steewbsd/quincy/doc/MaterialList.ods

Sheet: IC
Component | Type | Value | Size | Provider
EFM32GG11B120F2048GQ64 | MCU | N/A | TQFP | DigiKey
FL4000157Z | HF Crystal | 48MHz 15pF | 3.2mm*2.5mm | DigiKey
G8327A058 | LF Crystal | 32.768kHz 12.5 pF | 3.2mm*1.5mm | DigiKey
BMI088 | IMU | N/A | 16LGA | DigiKey
FAN7888MX | 3-P Gate Driver | N/A | 28-SOIC | DigiKey
TLP2366 | Optoisolator | 40ns | SO-6 | DigiKey
1984620 | Term. Block | 3 hole, 12A, 5mm | N/A | DigiKey
BQ7694202PFBR | Battery Protector | 3S – 10S | TQFP-48 | DigiKey
AMT49406GLPTR | BLDC Controller | FOC | 24-TSSOP-EP | DigiKey
IRF540NPBF | High Side FET | N-CH Si 100V 33A | TO-220AB | DigiKey
IRF540NPBF | Low Side FET | N-CH Si 100V 33A | TO-220AB | DigiKey
BM61M22BFJ-C | Isolated Gate Driver | 1ch 2500Vrms 60ns | SOP-JW8 | DigiKey
DRV8300UDPWR | Gate Driver | Three Phase BLDC | 20-TSSOP | DigiKey
IMC101TT038XUMA1 | BLDC Controller | Three Phase BLDC | TSSOP-38 | DigiKey
MICRF219AAYQS-TR | Receiver RF ASK/OOK | 433MHz @ 20Kbps | 16QSOP | DigiKey
ABLS-13.52127MHZ-10-J-4Q-T | XTAL RF | 13.52MHz | HC-47/US | DigiKey
AS179-92LF | RF Switch | Max 2GHz, 0.4 dB IL, P1Db = 34 dBm, 50 Ohm | SC-70-6 | DigiKey
MICRF113YM6-TR | Transmitter RF ASK | 433Mhz @ 115 Kbps | SOT23-6 | DigiKey
RF2-04A-T-00-50-G | SMA Receptacle | 50 Ohm, Female |  | DigiKey
AO3400A | N-MOS FET | Vgs = 1.05 V | SOT-23-3L | DigiKey
AO3401A | P-MOS FET | Vgs = -0.9 V | SOT-23-3L | DigiKey
BAT46W-7-F | Rev. Protection Diode | Vr = 100 V, Schottky | SOD-123 | DigiKey
ERT-J1VR103J | Thermistor NTC | Ra = 10K, 1% | Pearl | DigiKey
ITV5432L1230WR | Fuse Triggerable | 30 A, 12 V | 5.4mm x 3.2mm x 1.8mm | DigiKey
FCX495TA | BJT REG | 100V,1A,2.3W,100 MHz | TO-252-3 DPAK | DigiKey
TPS562202S | Voltage Reg.
36-1122-ND | Battery Holder | 21700 |  | DigiKey

Sheet: Capacitors
Component | Type | Value | Size | Provider
CC0603BRNPO9BN1R2 | Cap. C0G | 1.2 pF | 0603 | DigiKey
CC0603BRNPO9BN1R5 | Cap. C0G | 1.5 pF | 0603 | DigiKey
CL10C4R7BB8NNNC | Cap. C0G | 4.7 pF | 0603 | DigiKey
CL21C100CBANNNC | Cap. C0G | 10 pF | 0805 | DigiKey
CL10C120JB8NNNC | Cap. C0G | 12 pF | 0603 | DigiKey
CL21C101JBANNNC | Cap. C0G | 100 pF | 0805 | DigiKey
CL21C221JBANNNC | Cap. C0G | 220 pF | 0805 | DigiKey
CL21B222KDCNFNC | Cap. X7R | 2.2 nF | 0805 | DigiKey
CL21B472KDCNNNC | Cap. X7R | 4.7 nF | 0805 | DigiKey
CL21B103KBANNNC | Cap. X5R | 10 nF | 0805 | DigiKey
CL21B104KBCNNNC | Cap. X7R | 0.1 uF | 0805 | DigiKey
CL21B224KBFNFNE | Cap. X7R | 0.22 uF | 0805 | DigiKey
CL21B474KBFNNNG | Cap. X7R | 0.47 uF | 0805 | DigiKey
CL21B105KAFNNNE | Cap. X7R | 1 uF | 0805 | DigiKey
CL21B225KPFNNNE | Cap. X7R | 2.2 uF | 0805 | DigiKey
CL21A106KOQNNNE | Cap. X5R | 10 uF | 0805 | DigiKey
CL21X226MOYNNWE | Cap. X6S | 22 uF | 0805 | DigiKey

Sheet: Resistors
Component | Type | Value | Size | Provider
ERJ-6GEY0R00V | RES 5% ⅛ W | 0 Ohm | 0805 | DigiKey
CRE2512-FZ-R005E-2 | RES 1% 2W | 5 mOhm | 2512 | DigiKey
ERJ-6RQF1R0V | RES 1% ⅛ W | 1 Ohm | 0805 | DigiKey
ERJ-6GEYJ100V | RES 5% ⅛ W | 10 Ohm | 0805 | DigiKey
ERJ-6GEYJ200V | RES 5% ⅛ W | 20 Ohm | 0805 | DigiKey
ERJ-6GEYJ101V | RES 5% ⅛ W | 100 Ohm | 0805 | DigiKey
ERJ-6ENF2001V | RES 1% ⅛ W | 2 kOhm | 0805 | DigiKey
ERJ-6ENF3901V | RES 5% ⅛ W | 3.9 kOhm | 0805 | DigiKey
ERJ-6GEYJ472V | RES 5% ⅛ W | 4.7 kOhm | 0805 | DigiKey
ERJ-6GEYJ103V | RES 5% ⅛ W | 10 kOhm | 0805 | DigiKey
ERJ-6ENF3092V | RES 1% ⅛ W | 30.9 kOhm | 0805 | DigiKey
ERJ-6GEYJ513V | RES 5% ⅛ W | 50 kOhm | 0805 | DigiKey
ERJ-6GEYJ104V | RES 5% ⅛ W | 100 kOhm | 0805 | DigiKey
ERJ-6GEYJ304V | RES 5% ⅛ W | 300 kOhm | 0805 | DigiKey
ERJ-6GEYJ106V | RES 5% ⅛ W | 10 Mohm | 0805 | DigiKey

Sheet: Inductors
Component | Type | Value | Size | Provider
AWCS0016100833NJ00 | RF Choke | 33 nH | 0603 | DigiKey
BWCS0012070739NJ00 | RF Choke | 39 nH | 0402 | DigiKey
LQW18AS68NG00D | RF Choke | 68 nH | 0603 | DigiKey
BWLS00100606R47K00 | RF Choke | 470 nH | 0402 | DigiKey
VLS5045EX-3R3N | Inductor 4.2A | 3.3 uH | N.S. | DigiKey
