steewbsd/quincy/doc/output/edgecuts.dxf

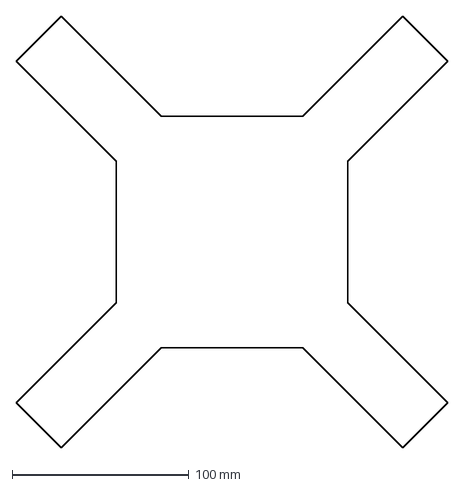
[picture p1: CAD file, 2024-11-16]
doc/output/edgecuts.dxf
244.0 x 244.0 mm
