steewbsd/quincy/(list of files, cad)

Other CAD files:
doc/EdgeCuts.FCStd
