steewbsd/quincy/doc/output/qfmu.pdf

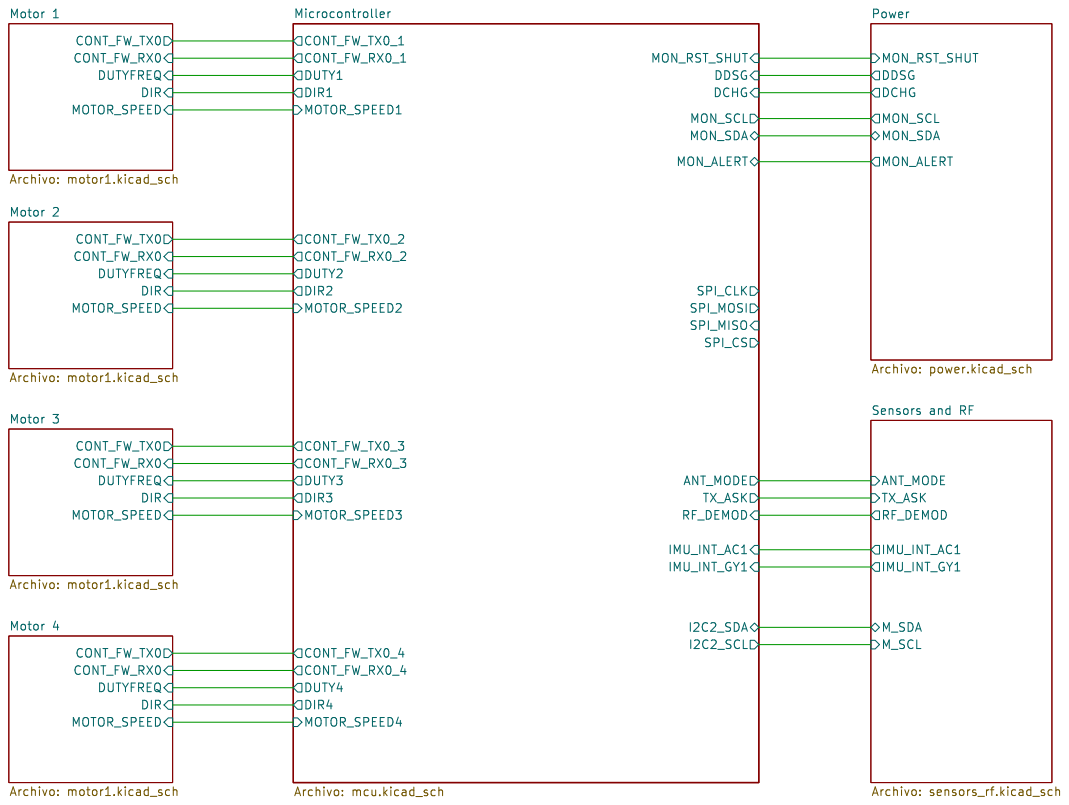
[picture p2: page 1]

Power Archivo: power.kicad_sch
I2C2_SCL MON_RST_SHUT DDSG
DCHG MON_SCL MON_SDA MON_ALERT RF_DEMOD
Sensors and RF Archivo: sensors_rf.kicad_sch

Id: 1/8 Title: Quincy FMU

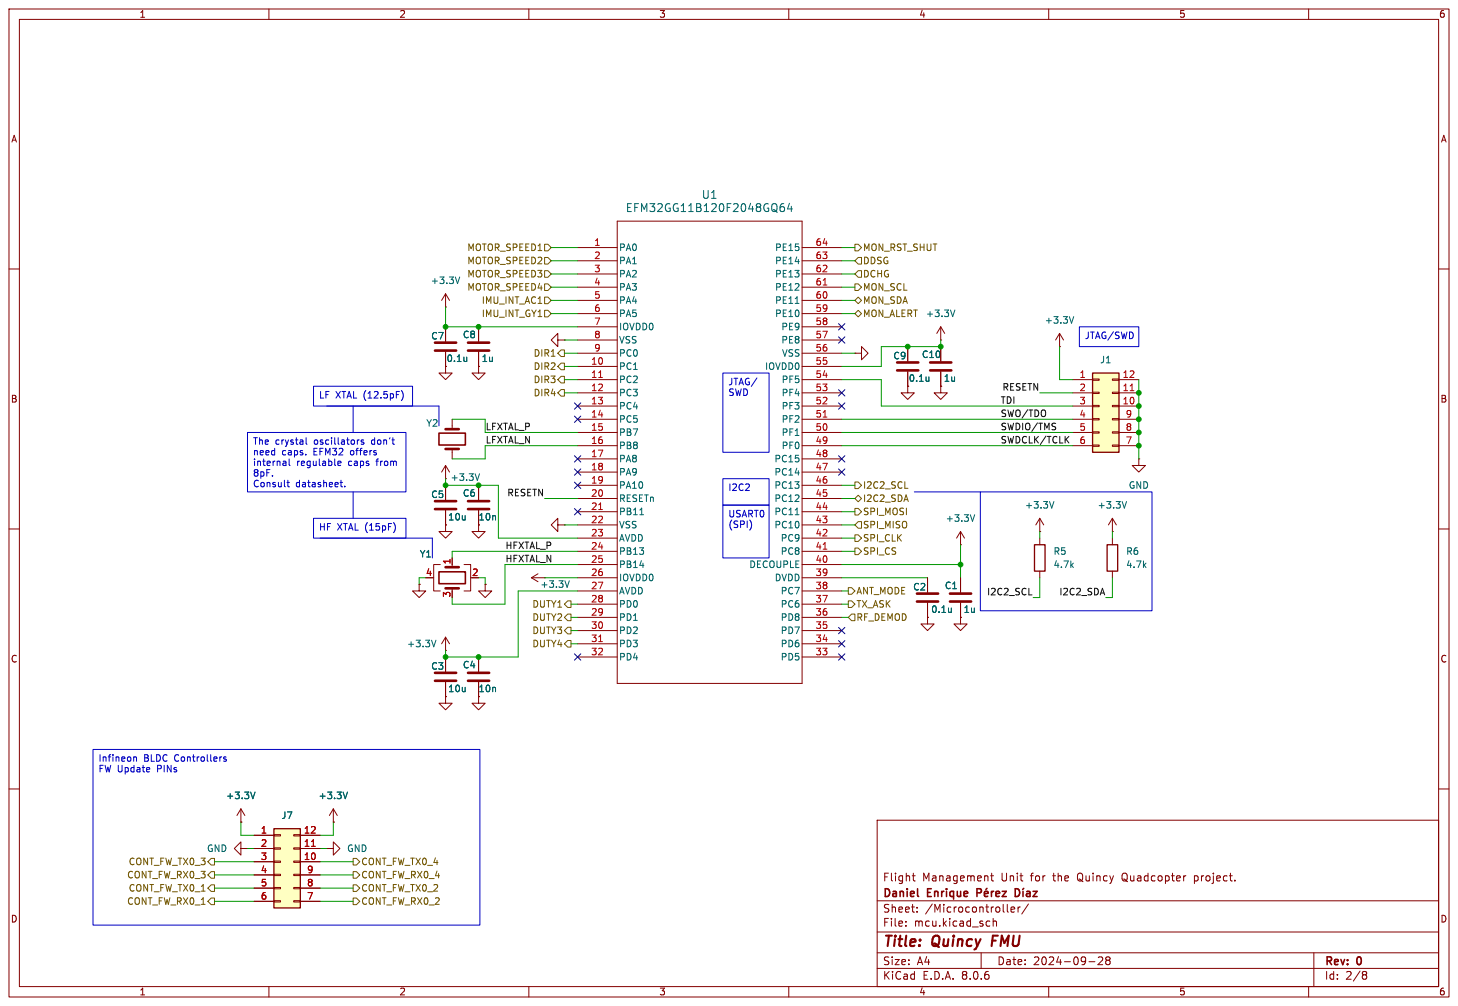
[picture p3: page 2]

Id: 2/8 Title: Quincy FMU

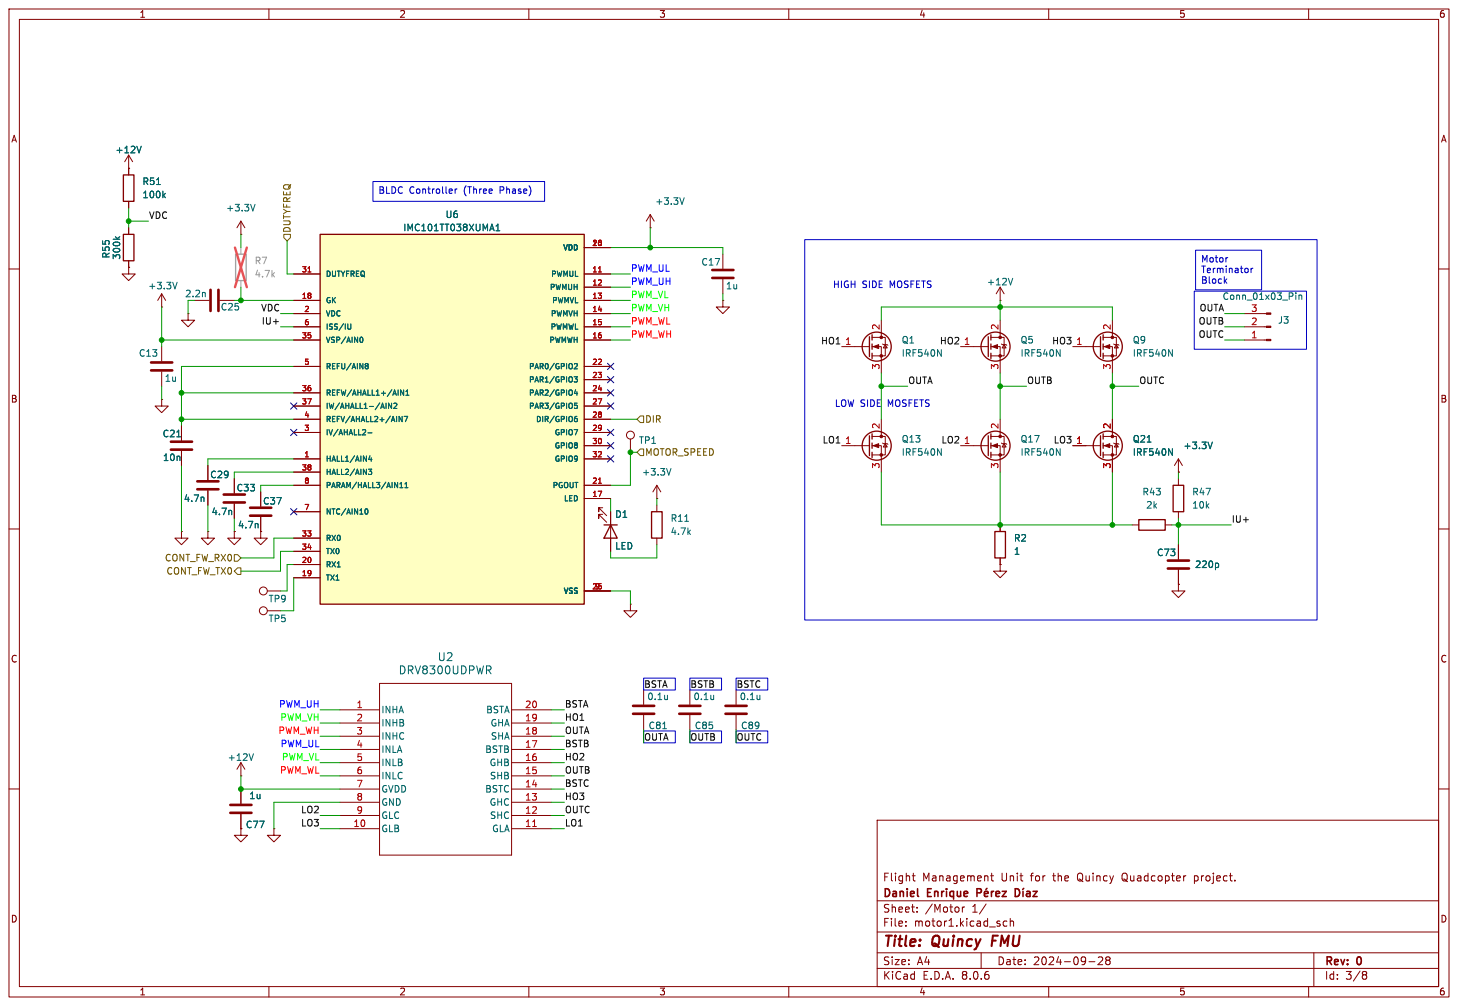
[picture p4: page 3]

LOW SIDE MOSFETS HIGH SIDE MOSFETS

Id: 3/8 Title: Quincy FMU

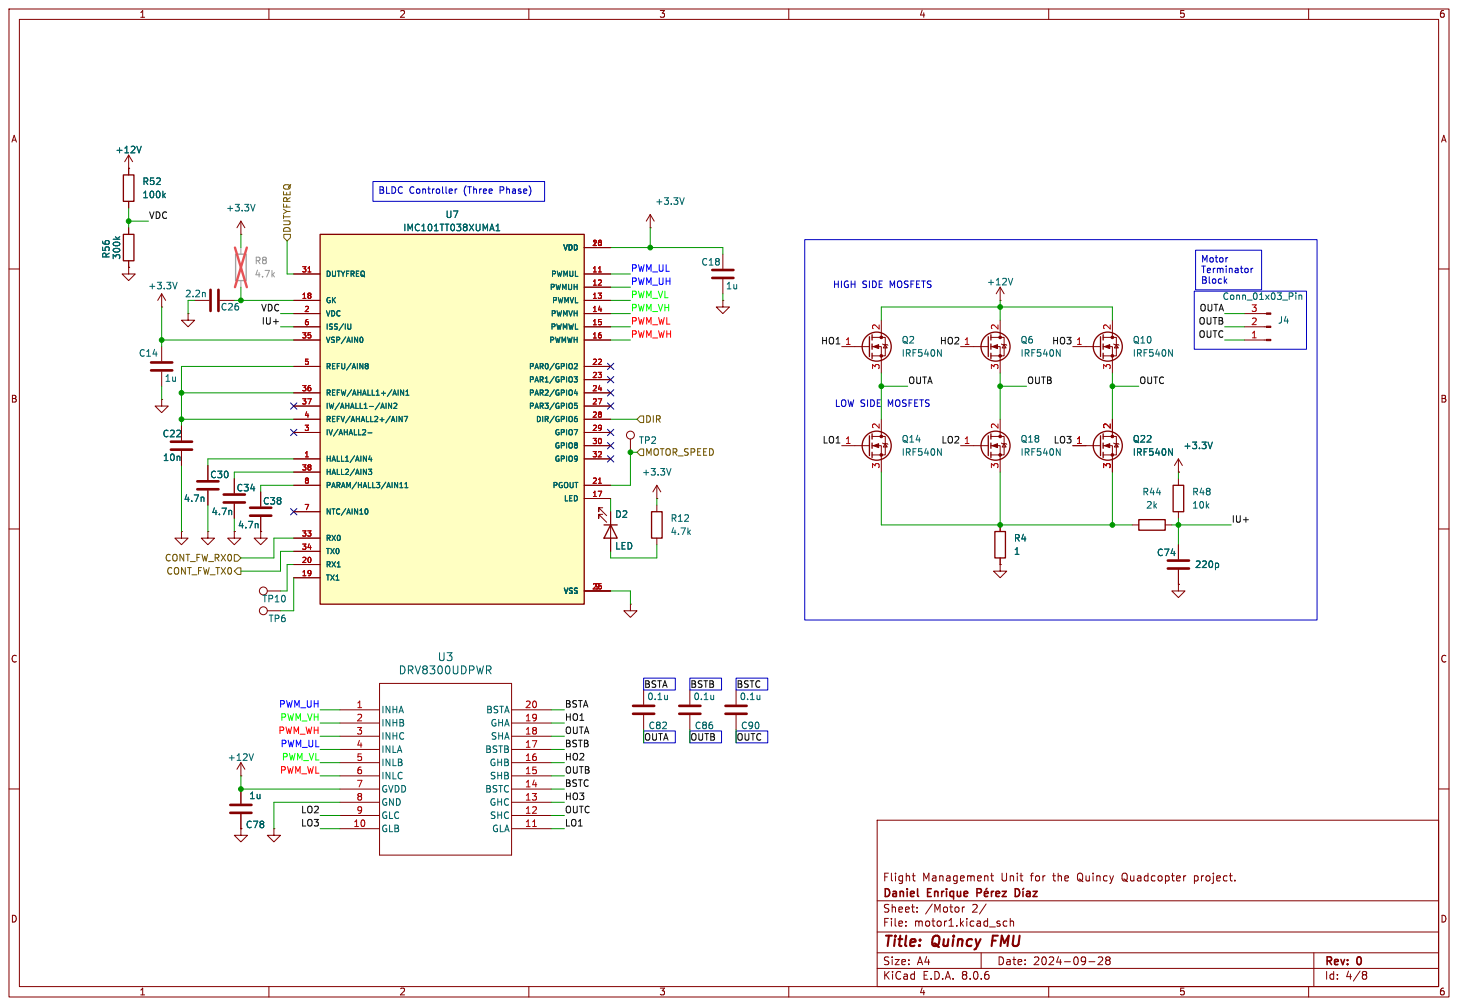
[picture p5: page 4]

Id: 4/8 Title: Quincy FMU

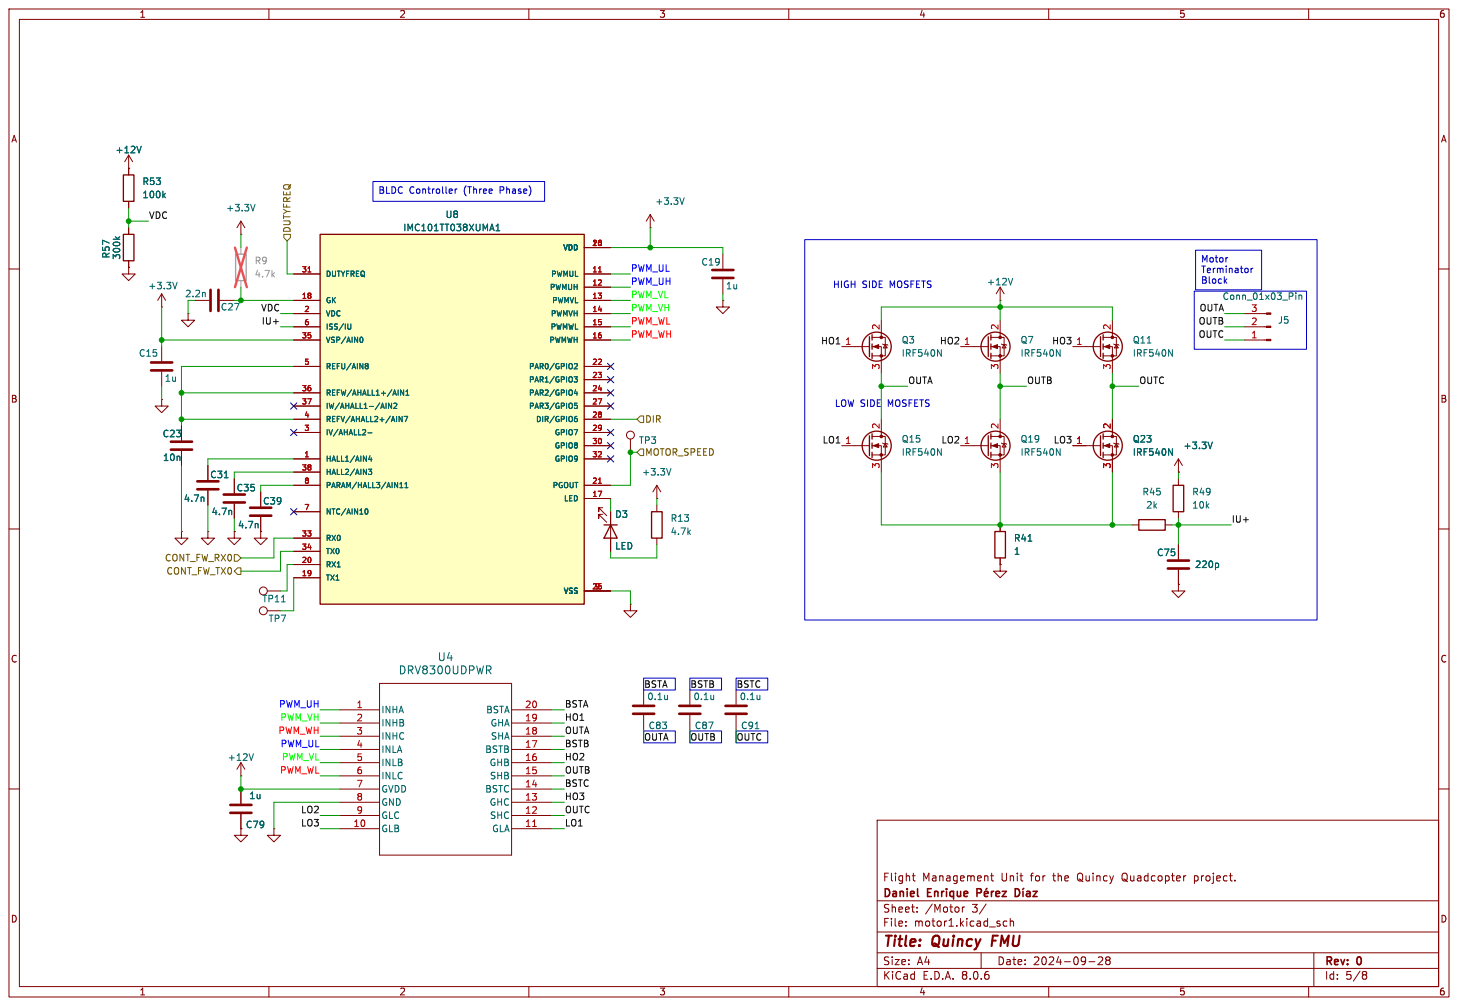
[picture p6: page 5]

LOW SIDE MOSFETS HIGH SIDE MOSFETS

Id: 5/8 Title: Quincy FMU

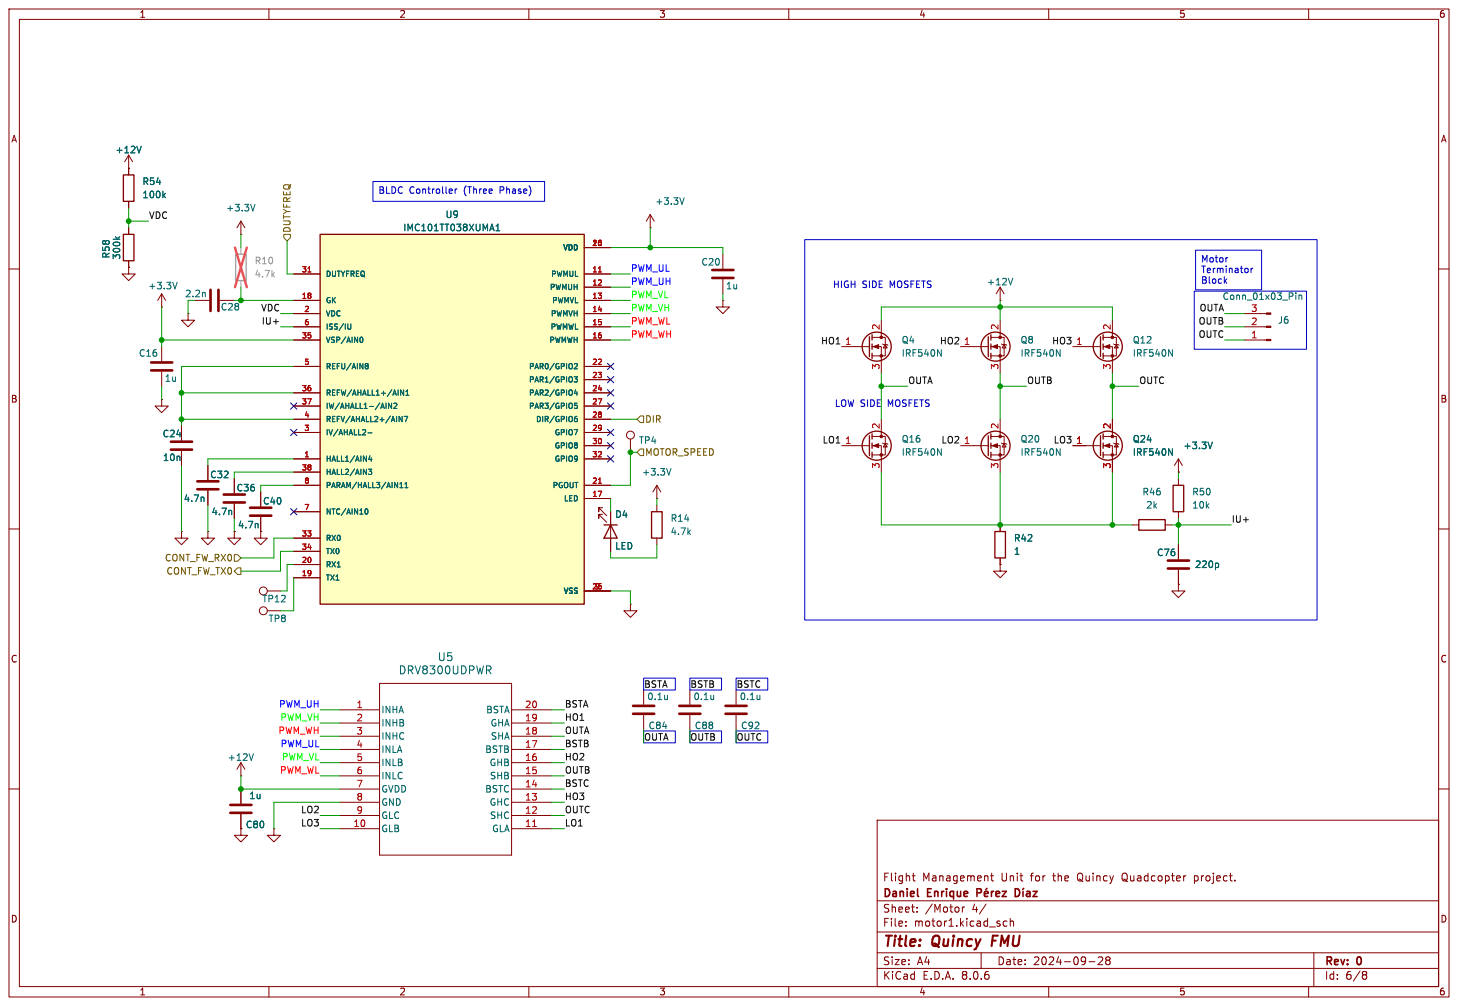
[picture p7: page 6]

LOW SIDE MOSFETS HIGH SIDE MOSFETS

Id: 6/8 Title: Quincy FMU

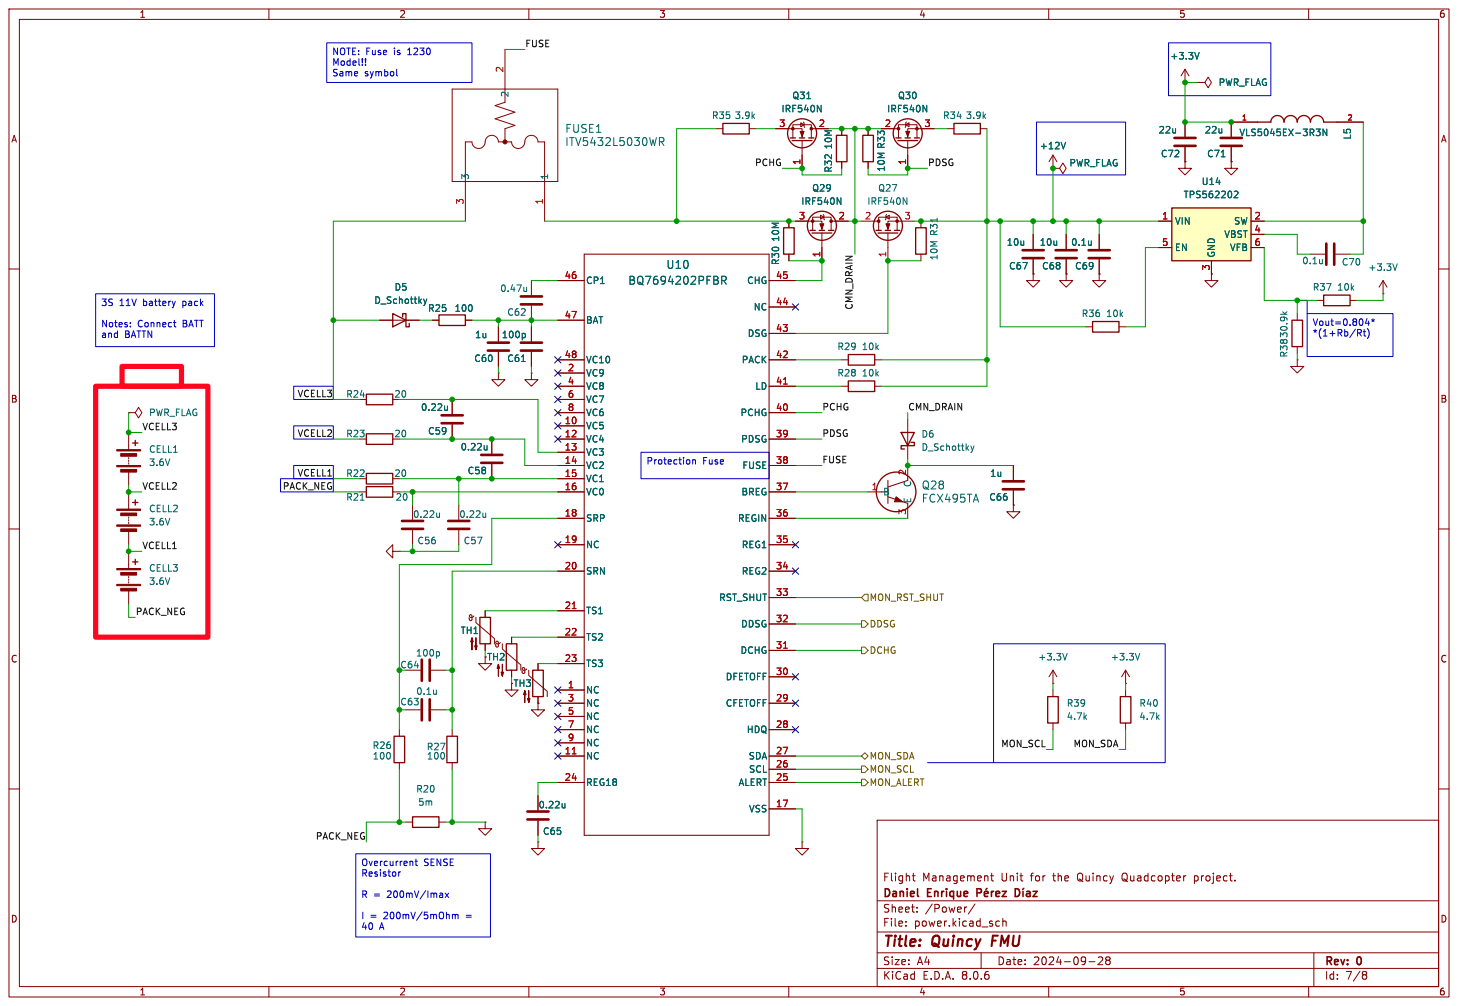
[picture p8: page 7]

NOTE: Fuse is 1230 Model!! Same symbol

3S 11V battery pack Notes: Connect BATT

Id: 7/8 Title: Quincy FMU

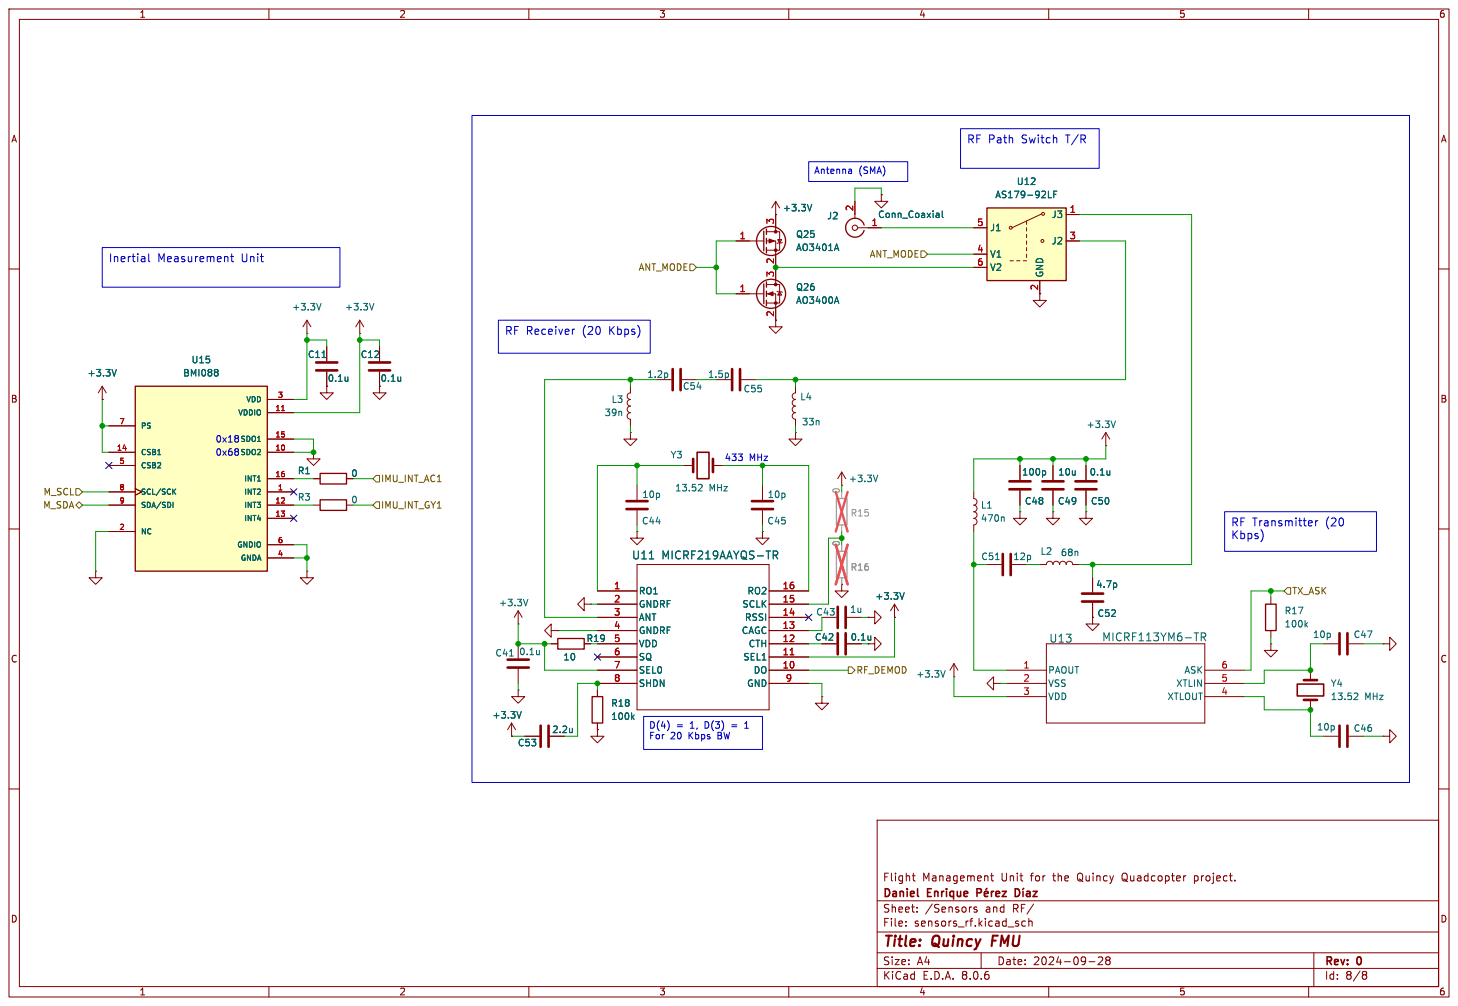
[picture p9: page 8]

Id: 8/8 Title: Quincy FMU
