steewbsd/quincy/hw/qfmu/qfmu.kicad_pcb

## KiCad design hw/qfmu/qfmu.kicad_pcb (2024-11-17)

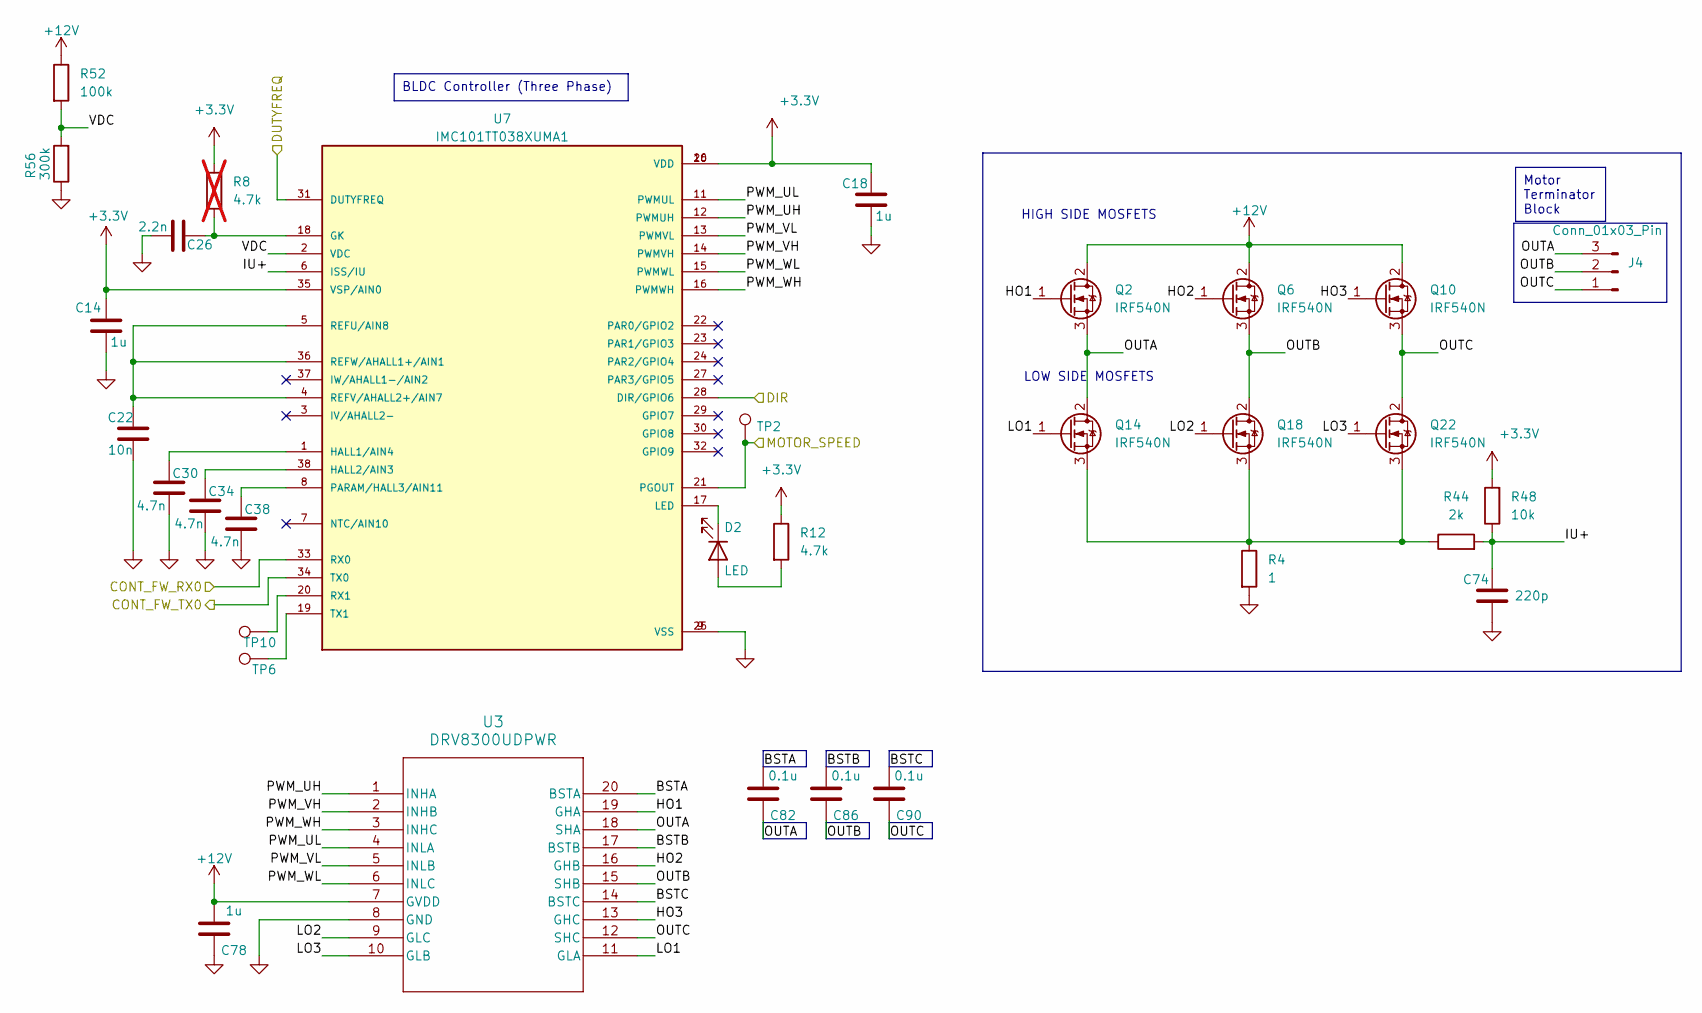
[picture p10: schematic motor1.kicad_sch, Quincy FMU]

Parts:
C14, C18, C78: 1u; C_0805_2012Metric_Pad1.18x1.45mm_HandSolder
C22: 10n; C_0805_2012Metric_Pad1.18x1.45mm_HandSolder
C26: 2.2n; C_0805_2012Metric_Pad1.18x1.45mm_HandSolder
C30, C34, C38: 4.7n; C_0805_2012Metric_Pad1.18x1.45mm_HandSolder
C74: 220p; C_0805_2012Metric_Pad1.18x1.45mm_HandSolder
C82, C86, C90: 0.1u; C_0805_2012Metric_Pad1.18x1.45mm_HandSolder
D2: LED; LED_1206_3216Metric_Pad1.42x1.75mm_HandSolder
J4: Conn_01x03_Pin; PhoenixContact_SPT_1.5_3-H-3.5_1x03_P3.5mm_Horizontal
Q2, Q6, Q10, Q14, Q18, Q22: IRF540N; TO-220-3_Horizontal_TabDown
R4: 1; R_0805_2012Metric_Pad1.20x1.40mm_HandSolder
R8: 4.7k; R_0805_2012Metric_Pad1.20x1.40mm_HandSolder; not fitted
R12: 4.7k; R_0805_2012Metric_Pad1.20x1.40mm_HandSolder
R44: 2k; R_0805_2012Metric_Pad1.20x1.40mm_HandSolder
R48: 10k; R_0805_2012Metric_Pad1.20x1.40mm_HandSolder
R52: 100k; R_0805_2012Metric_Pad1.20x1.40mm_HandSolder
R56: 300k; R_0805_2012Metric_Pad1.20x1.40mm_HandSolder
TP2, TP6, TP10: TestPoint; Pin_D0.7mm_L6.5mm_W1.8mm_FlatFork
U3: DRV8300UDPWR; TSSOP_0DIPWR_TEX
U7: IMC101TT038XUMA1; SOP50P640X110-38N; PARTREV 1.6

Connections:
+3.3V: C14.1, C18.1, R8.1, R12.1, R48.2, U7.10 (VDD), U7.26 (VDD), U7.35 (VSP/AIN0); also elsewhere on the board
+12V: C78.2, Q2.2 (D), Q6.2 (D), Q10.2 (D), R52.1, U3.7 (GVDD); also elsewhere on the board
/Microcontroller/CONT_FW_RX0_2: U7.33 (RX0); also elsewhere on the board
/Microcontroller/CONT_FW_TX0_2: U7.34 (TX0); also elsewhere on the board
/Microcontroller/DIR2: U7.28 (DIR/GPIO6); also elsewhere on the board
/Microcontroller/DUTY2: U7.31 (DUTYFREQ); also elsewhere on the board
/Microcontroller/MOTOR_SPEED2: TP2.1, U7.21 (PGOUT); also elsewhere on the board
/Motor 2/BSTA: C82.2, U3.20 (BSTA)
/Motor 2/BSTB: C86.2, U3.17 (BSTB)
/Motor 2/BSTC: C90.2, U3.14 (BSTC)
/Motor 2/HO1: Q2.1 (G), U3.19 (GHA)
/Motor 2/HO2: Q6.1 (G), U3.16 (GHB)
/Motor 2/HO3: Q10.1 (G), U3.13 (GHC)
/Motor 2/IU+: C74.1, R44.2, R48.1, U7.6 (ISS/IU)
/Motor 2/LO1: Q14.1 (G), U3.11 (GLA)
/Motor 2/LO2: Q18.1 (G), U3.9 (GLC)
/Motor 2/LO3: Q22.1 (G), U3.10 (GLB)
/Motor 2/OUTA: C82.1, J4.3, Q2.3 (S), Q14.2 (D), U3.18 (SHA)
/Motor 2/OUTB: C86.1, J4.2, Q6.3 (S), Q18.2 (D), U3.15 (SHB)
/Motor 2/OUTC: C90.1, J4.1, Q10.3 (S), Q22.2 (D), U3.12 (SHC)
/Motor 2/PWM_UH: U3.1 (INHA), U7.12 (PWMUH)
/Motor 2/PWM_UL: U3.4 (INLA), U7.11 (PWMUL)
/Motor 2/PWM_VH: U3.2 (INHB), U7.14 (PWMVH)
/Motor 2/PWM_VL: U3.5 (INLB), U7.13 (PWMVL)
/Motor 2/PWM_WH: U3.3 (INHC), U7.16 (PWMWH)
/Motor 2/PWM_WL: U3.6 (INLC), U7.15 (PWMWL)
/Motor 2/VDC: R52.2, R56.2, U7.2 (VDC)
GND: C14.2, C18.2, C22.2, C26.1, C30.2, C34.2, C38.2, C74.2, C78.1, R4.2, R56.1, U3.8 (GND), U7.9 (VSS), U7.25 (VSS); also elsewhere on the board
unnamed: D2.2 (A), R12.2
unnamed: D2.1 (K), U7.17 (LED)
unnamed: Q14.3 (S), Q18.3 (S), Q22.3 (S), R4.1, R44.1
unnamed: C26.2, R8.2, U7.18 (GK)
unnamed: C30.1, U7.1 (HALL1/AIN4)
unnamed: C34.1, U7.38 (HALL2/AIN3)
unnamed: C38.1, U7.8 (PARAM/HALL3/AIN11)
unnamed: C22.1, U7.4 (REFV/AHALL2+/AIN7), U7.5 (REFU/AIN8), U7.36 (REFW/AHALL1+/AIN1)
unnamed: TP10.1, U7.20 (RX1)
unnamed: TP6.1, U7.19 (TX1)

Parts of its further copies:
C13, C15, C16, C17, C19, C20, C77, C79, C80: 1u; C_0805_2012Metric_Pad1.18x1.45mm_HandSolder
C21, C23, C24: 10n; C_0805_2012Metric_Pad1.18x1.45mm_HandSolder
C25, C27, C28: 2.2n; C_0805_2012Metric_Pad1.18x1.45mm_HandSolder
C29, C31, C32, C33, C35, C36, C37, C39, C40: 4.7n; C_0805_2012Metric_Pad1.18x1.45mm_HandSolder
C73, C75, C76: 220p; C_0805_2012Metric_Pad1.18x1.45mm_HandSolder
C81, C83, C84, C85, C87, C88, C89, C91, C92: 0.1u; C_0805_2012Metric_Pad1.18x1.45mm_HandSolder
D1, D3, D4: LED; LED_1206_3216Metric_Pad1.42x1.75mm_HandSolder
J3, J5, J6: Conn_01x03_Pin; PhoenixContact_SPT_1.5_3-H-3.5_1x03_P3.5mm_Horizontal
Q1, Q3, Q4, Q5, Q7, Q8, Q9, Q11, Q12, Q13, Q15, Q16, Q17, Q19, Q20, Q21, Q23, Q24: IRF540N; TO-220-3_Horizontal_TabDown
R2, R41, R42: 1; R_0805_2012Metric_Pad1.20x1.40mm_HandSolder
R7, R9, R10: 4.7k; R_0805_2012Metric_Pad1.20x1.40mm_HandSolder; not fitted
R11, R13, R14: 4.7k; R_0805_2012Metric_Pad1.20x1.40mm_HandSolder
R43, R45, R46: 2k; R_0805_2012Metric_Pad1.20x1.40mm_HandSolder
R47, R49, R50: 10k; R_0805_2012Metric_Pad1.20x1.40mm_HandSolder
R51, R53, R54: 100k; R_0805_2012Metric_Pad1.20x1.40mm_HandSolder
R55, R57, R58: 300k; R_0805_2012Metric_Pad1.20x1.40mm_HandSolder
TP1, TP3, TP4, TP5, TP7, TP8, TP9, TP11, TP12: TestPoint; Pin_D0.7mm_L6.5mm_W1.8mm_FlatFork
U2, U4, U5: DRV8300UDPWR; TSSOP_0DIPWR_TEX
U6, U8, U9: IMC101TT038XUMA1; SOP50P640X110-38N; PARTREV 1.6

Connections of its further copies:
+3.3V: C13.1, C15.1, C16.1, C17.1, C19.1, C20.1, R7.1, R9.1, R10.1, R11.1, R13.1, R14.1, R47.2, R49.2, R50.2, U6.10 (VDD), U6.26 (VDD), U6.35 (VSP/AIN0), U8.10 (VDD), U8.26 (VDD), U8.35 (VSP/AIN0), U9.10 (VDD), U9.26 (VDD), U9.35 (VSP/AIN0); also elsewhere on the board
+12V: C77.2, C79.2, C80.2, Q1.2 (D), Q3.2 (D), Q4.2 (D), Q5.2 (D), Q7.2 (D), Q8.2 (D), Q9.2 (D), Q11.2 (D), Q12.2 (D), R51.1, R53.1, R54.1, U2.7 (GVDD), U4.7 (GVDD), U5.7 (GVDD); also elsewhere on the board
/Microcontroller/CONT_FW_RX0_1: U6.33 (RX0); also elsewhere on the board
/Microcontroller/CONT_FW_RX0_3: U8.33 (RX0); also elsewhere on the board
/Microcontroller/CONT_FW_RX0_4: U9.33 (RX0); also elsewhere on the board
/Microcontroller/CONT_FW_TX0_1: U6.34 (TX0); also elsewhere on the board
/Microcontroller/CONT_FW_TX0_3: U8.34 (TX0); also elsewhere on the board
/Microcontroller/CONT_FW_TX0_4: U9.34 (TX0); also elsewhere on the board
/Microcontroller/DIR1: U6.28 (DIR/GPIO6); also elsewhere on the board
/Microcontroller/DIR3: U8.28 (DIR/GPIO6); also elsewhere on the board
/Microcontroller/DIR4: U9.28 (DIR/GPIO6); also elsewhere on the board
/Microcontroller/DUTY1: U6.31 (DUTYFREQ); also elsewhere on the board
/Microcontroller/DUTY3: U8.31 (DUTYFREQ); also elsewhere on the board
/Microcontroller/DUTY4: U9.31 (DUTYFREQ); also elsewhere on the board
/Microcontroller/MOTOR_SPEED1: TP1.1, U6.21 (PGOUT); also elsewhere on the board
/Microcontroller/MOTOR_SPEED3: TP3.1, U8.21 (PGOUT); also elsewhere on the board
/Microcontroller/MOTOR_SPEED4: TP4.1, U9.21 (PGOUT); also elsewhere on the board
/Motor 1/BSTA: C81.2, U2.20 (BSTA)
/Motor 1/BSTB: C85.2, U2.17 (BSTB)
/Motor 1/BSTC: C89.2, U2.14 (BSTC)
/Motor 1/HO1: Q1.1 (G), U2.19 (GHA)
/Motor 1/HO2: Q5.1 (G), U2.16 (GHB)
/Motor 1/HO3: Q9.1 (G), U2.13 (GHC)
/Motor 1/IU+: C73.1, R43.2, R47.1, U6.6 (ISS/IU)
/Motor 1/LO1: Q13.1 (G), U2.11 (GLA)
/Motor 1/LO2: Q17.1 (G), U2.9 (GLC)
/Motor 1/LO3: Q21.1 (G), U2.10 (GLB)
/Motor 1/OUTA: C81.1, J3.3, Q1.3 (S), Q13.2 (D), U2.18 (SHA)
/Motor 1/OUTB: C85.1, J3.2, Q5.3 (S), Q17.2 (D), U2.15 (SHB)
/Motor 1/OUTC: C89.1, J3.1, Q9.3 (S), Q21.2 (D), U2.12 (SHC)
/Motor 1/PWM_UH: U2.1 (INHA), U6.12 (PWMUH)
/Motor 1/PWM_UL: U2.4 (INLA), U6.11 (PWMUL)
/Motor 1/PWM_VH: U2.2 (INHB), U6.14 (PWMVH)
/Motor 1/PWM_VL: U2.5 (INLB), U6.13 (PWMVL)
/Motor 1/PWM_WH: U2.3 (INHC), U6.16 (PWMWH)
/Motor 1/PWM_WL: U2.6 (INLC), U6.15 (PWMWL)
/Motor 1/VDC: R51.2, R55.2, U6.2 (VDC)
/Motor 3/BSTA: C83.2, U4.20 (BSTA)
/Motor 3/BSTB: C87.2, U4.17 (BSTB)
/Motor 3/BSTC: C91.2, U4.14 (BSTC)
/Motor 3/HO1: Q3.1 (G), U4.19 (GHA)
/Motor 3/HO2: Q7.1 (G), U4.16 (GHB)
/Motor 3/HO3: Q11.1 (G), U4.13 (GHC)
/Motor 3/IU+: C75.1, R45.2, R49.1, U8.6 (ISS/IU)
/Motor 3/LO1: Q15.1 (G), U4.11 (GLA)
/Motor 3/LO2: Q19.1 (G), U4.9 (GLC)
/Motor 3/LO3: Q23.1 (G), U4.10 (GLB)
/Motor 3/OUTA: C83.1, J5.3, Q3.3 (S), Q15.2 (D), U4.18 (SHA)
/Motor 3/OUTB: C87.1, J5.2, Q7.3 (S), Q19.2 (D), U4.15 (SHB)
/Motor 3/OUTC: C91.1, J5.1, Q11.3 (S), Q23.2 (D), U4.12 (SHC)
/Motor 3/PWM_UH: U4.1 (INHA), U8.12 (PWMUH)
/Motor 3/PWM_UL: U4.4 (INLA), U8.11 (PWMUL)
/Motor 3/PWM_VH: U4.2 (INHB), U8.14 (PWMVH)
/Motor 3/PWM_VL: U4.5 (INLB), U8.13 (PWMVL)
/Motor 3/PWM_WH: U4.3 (INHC), U8.16 (PWMWH)
/Motor 3/PWM_WL: U4.6 (INLC), U8.15 (PWMWL)
/Motor 3/VDC: R53.2, R57.2, U8.2 (VDC)
/Motor 4/BSTA: C84.2, U5.20 (BSTA)
/Motor 4/BSTB: C88.2, U5.17 (BSTB)
/Motor 4/BSTC: C92.2, U5.14 (BSTC)
/Motor 4/HO1: Q4.1 (G), U5.19 (GHA)
/Motor 4/HO2: Q8.1 (G), U5.16 (GHB)
/Motor 4/HO3: Q12.1 (G), U5.13 (GHC)
/Motor 4/IU+: C76.1, R46.2, R50.1, U9.6 (ISS/IU)
/Motor 4/LO1: Q16.1 (G), U5.11 (GLA)
/Motor 4/LO2: Q20.1 (G), U5.9 (GLC)
/Motor 4/LO3: Q24.1 (G), U5.10 (GLB)
/Motor 4/OUTA: C84.1, J6.3, Q4.3 (S), Q16.2 (D), U5.18 (SHA)
/Motor 4/OUTB: C88.1, J6.2, Q8.3 (S), Q20.2 (D), U5.15 (SHB)
/Motor 4/OUTC: C92.1, J6.1, Q12.3 (S), Q24.2 (D), U5.12 (SHC)
/Motor 4/PWM_UH: U5.1 (INHA), U9.12 (PWMUH)
/Motor 4/PWM_UL: U5.4 (INLA), U9.11 (PWMUL)
/Motor 4/PWM_VH: U5.2 (INHB), U9.14 (PWMVH)
/Motor 4/PWM_VL: U5.5 (INLB), U9.13 (PWMVL)
/Motor 4/PWM_WH: U5.3 (INHC), U9.16 (PWMWH)
/Motor 4/PWM_WL: U5.6 (INLC), U9.15 (PWMWL)
/Motor 4/VDC: R54.2, R58.2, U9.2 (VDC)
GND: C13.2, C15.2, C16.2, C17.2, C19.2, C20.2, C21.2, C23.2, C24.2, C25.1, C27.1, C28.1, C29.2, C31.2, C32.2, C33.2, C35.2, C36.2, C37.2, C39.2, C40.2, C73.2, C75.2, C76.2, C77.1, C79.1, C80.1, R2.2, R41.2, R42.2, R55.1, R57.1, R58.1, U2.8 (GND), U4.8 (GND), U5.8 (GND), U6.9 (VSS), U6.25 (VSS), U8.9 (VSS), U8.25 (VSS), U9.9 (VSS), U9.25 (VSS); also elsewhere on the board
unnamed: D1.2 (A), R11.2
unnamed: D1.1 (K), U6.17 (LED)
unnamed: D3.2 (A), R13.2
unnamed: D3.1 (K), U8.17 (LED)
unnamed: D4.2 (A), R14.2
unnamed: D4.1 (K), U9.17 (LED)
unnamed: Q13.3 (S), Q17.3 (S), Q21.3 (S), R2.1, R43.1
unnamed: Q15.3 (S), Q19.3 (S), Q23.3 (S), R41.1, R45.1
unnamed: Q16.3 (S), Q20.3 (S), Q24.3 (S), R42.1, R46.1
unnamed: C25.2, R7.2, U6.18 (GK)
unnamed: C29.1, U6.1 (HALL1/AIN4)
unnamed: C33.1, U6.38 (HALL2/AIN3)
unnamed: C37.1, U6.8 (PARAM/HALL3/AIN11)
unnamed: C21.1, U6.4 (REFV/AHALL2+/AIN7), U6.5 (REFU/AIN8), U6.36 (REFW/AHALL1+/AIN1)
unnamed: TP9.1, U6.20 (RX1)
unnamed: TP5.1, U6.19 (TX1)
unnamed: C27.2, R9.2, U8.18 (GK)
unnamed: C31.1, U8.1 (HALL1/AIN4)
unnamed: C35.1, U8.38 (HALL2/AIN3)
unnamed: C39.1, U8.8 (PARAM/HALL3/AIN11)
unnamed: C23.1, U8.4 (REFV/AHALL2+/AIN7), U8.5 (REFU/AIN8), U8.36 (REFW/AHALL1+/AIN1)
unnamed: TP11.1, U8.20 (RX1)
unnamed: TP7.1, U8.19 (TX1)
unnamed: C28.2, R10.2, U9.18 (GK)
unnamed: C32.1, U9.1 (HALL1/AIN4)
unnamed: C36.1, U9.38 (HALL2/AIN3)
unnamed: C40.1, U9.8 (PARAM/HALL3/AIN11)
unnamed: C24.1, U9.4 (REFV/AHALL2+/AIN7), U9.5 (REFU/AIN8), U9.36 (REFW/AHALL1+/AIN1)
unnamed: TP12.1, U9.20 (RX1)
unnamed: TP8.1, U9.19 (TX1)

Notes on the sheet:
Motor Terminator Block
BLDC Controller (Three Phase)
HIGH SIDE MOSFETS
LOW SIDE MOSFETS

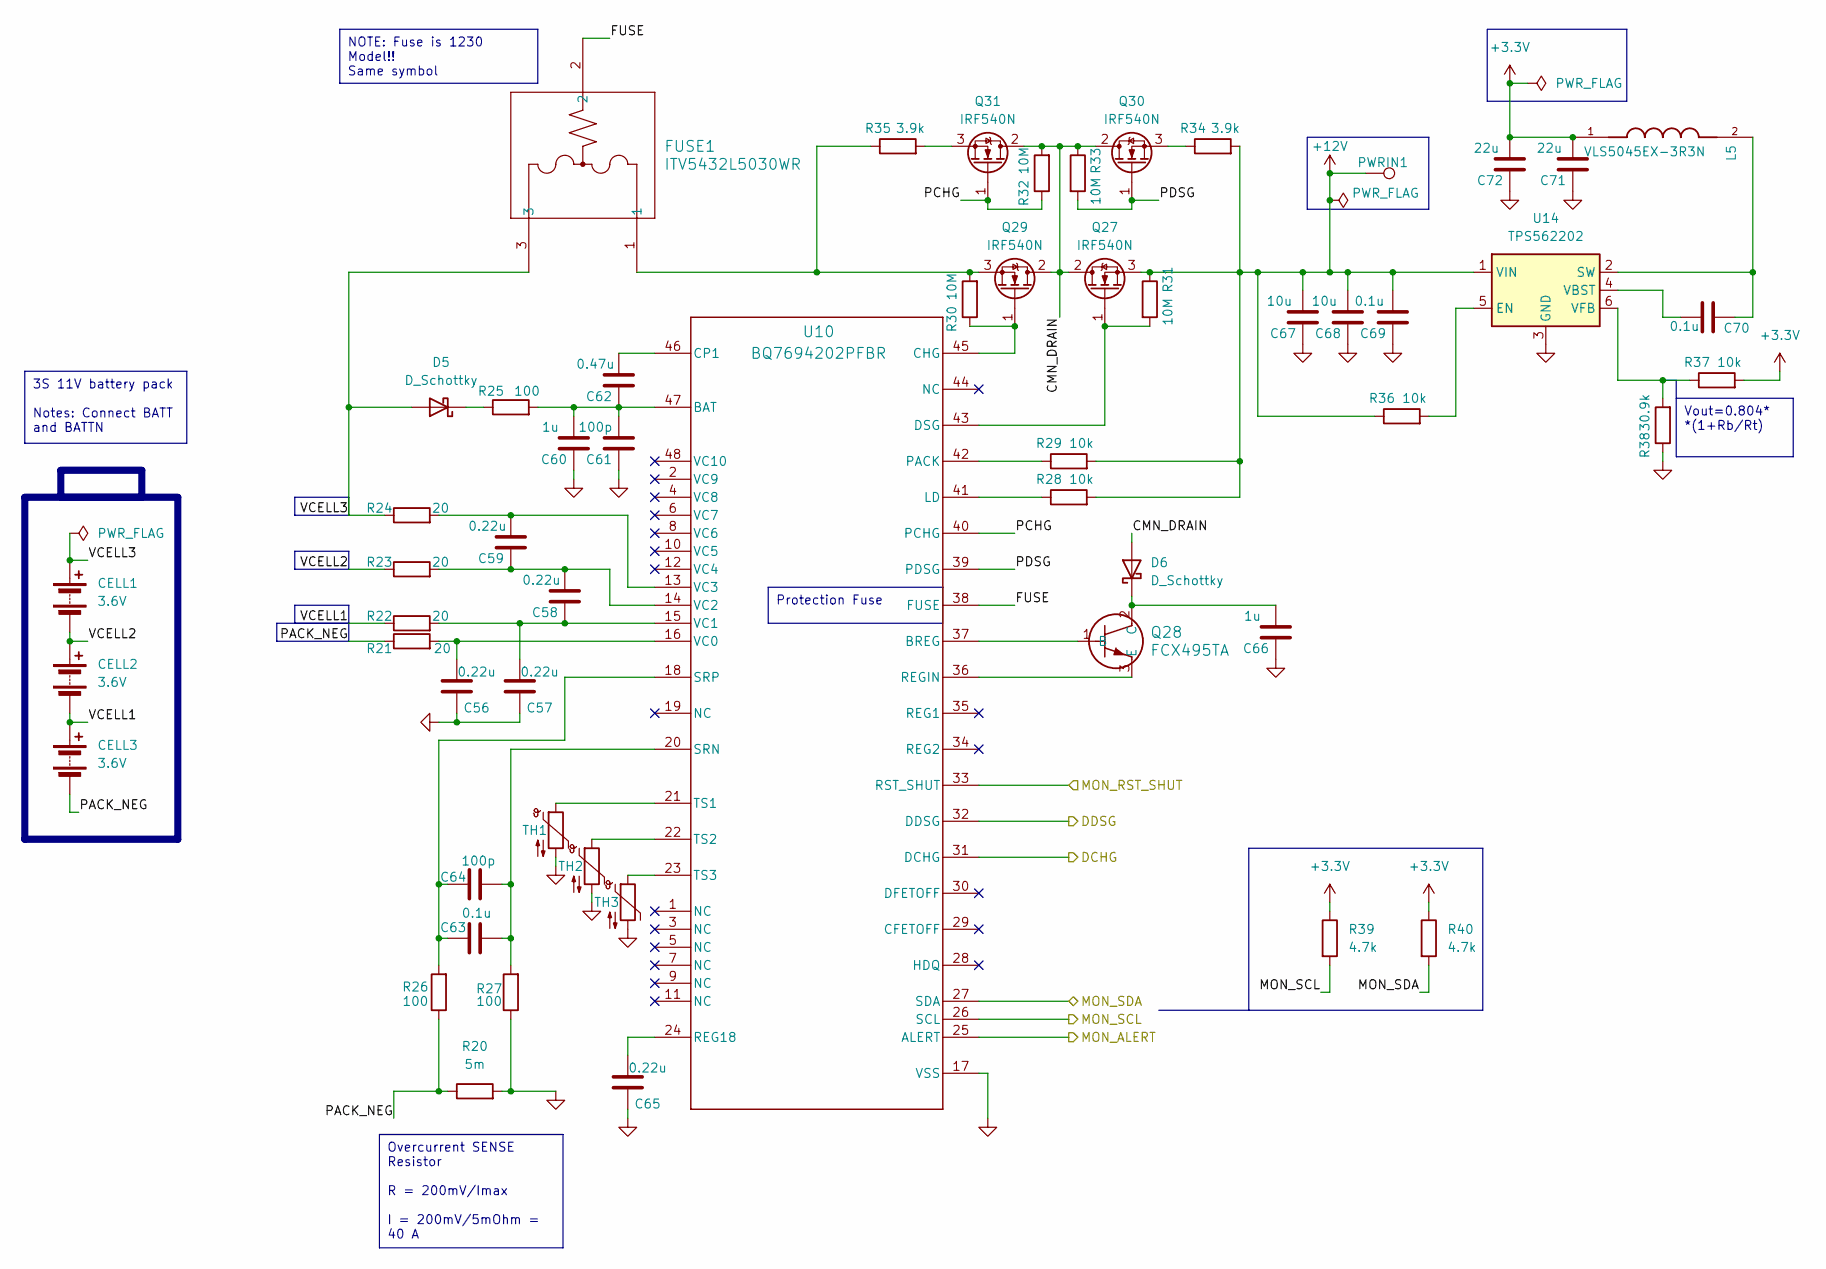
[picture p11: schematic power.kicad_sch, Quincy FMU]

Parts:
C56, C57, C58, C59, C65: 0.22u; C_0805_2012Metric_Pad1.18x1.45mm_HandSolder
C60, C66: 1u; C_0805_2012Metric_Pad1.18x1.45mm_HandSolder
C61, C64: 100p; C_0805_2012Metric_Pad1.18x1.45mm_HandSolder
C62: 0.47u; C_0805_2012Metric_Pad1.18x1.45mm_HandSolder
C63, C69, C70: 0.1u; C_0805_2012Metric_Pad1.18x1.45mm_HandSolder
C67, C68: 10u; C_0805_2012Metric_Pad1.18x1.45mm_HandSolder
C71, C72: 22u; C_0805_2012Metric_Pad1.18x1.45mm_HandSolder
CELL1, CELL2, CELL3: 3.6V
D5, D6: D_Schottky; D_SOD-123
FUSE1: ITV5432L5030WR; QFN4_ITV5432_LTF
L5: VLS5045EX-3R3N; IND_VLS5045EX-3R3N; PARTREV N/A
PWRIN1: TestPoint; Pin_D0.7mm_L6.5mm_W1.8mm_FlatFork
Q27, Q29, Q30, Q31: IRF540N; TO-220-3_Horizontal_TabDown
Q28: FCX495TA; SOT89_DIO
R20: 5m; R_2512_6332Metric_Pad1.40x3.35mm_HandSolder
R21, R22, R23, R24: 20; R_0805_2012Metric_Pad1.20x1.40mm_HandSolder
R25, R26, R27: 100; R_0805_2012Metric_Pad1.20x1.40mm_HandSolder
R28, R29, R36, R37: 10k; R_0805_2012Metric_Pad1.20x1.40mm_HandSolder
R30, R31, R32, R33: 10M; R_0805_2012Metric_Pad1.20x1.40mm_HandSolder
R34, R35: 3.9k; R_0805_2012Metric_Pad1.20x1.40mm_HandSolder
R38: 30.9k; R_0805_2012Metric_Pad1.20x1.40mm_HandSolder
R39, R40: 4.7k; R_0805_2012Metric_Pad1.20x1.40mm_HandSolder
TH1, TH2, TH3: Thermistor_NTC; R_0603_1608Metric_Pad0.98x0.95mm_HandSolder
U10: BQ7694202PFBR; PFB0048A_N
U14: TPS562202; SOT-563

Connections:
+3.3V: C71.2, C72.2, L5.1, R37.2, R39.1, R40.1; also elsewhere on the board
+12V: C67.2, C68.2, C69.2, PWRIN1.1, Q27.3 (S), R28.2, R29.2, R31.1, R34.2, R36.1, U14.1 (VIN); also elsewhere on the board
/Microcontroller/DCHG: U10.31 (DCHG); also elsewhere on the board
/Microcontroller/DDSG: U10.32 (DDSG); also elsewhere on the board
/Microcontroller/MON_ALERT: U10.25 (ALERT); also elsewhere on the board
/Microcontroller/MON_RST_SHUT: U10.33 (RST_SHUT); also elsewhere on the board
/Power/CMN_DRAIN: D6.2 (A), Q27.2 (D), Q29.2 (D), Q30.2 (D), Q31.2 (D), R32.2, R33.1
/Power/FUSE: FUSE1.2, U10.38 (FUSE)
/Power/MON_SCL: R39.2, U10.26 (SCL); also elsewhere on the board
/Power/MON_SDA: R40.2, U10.27 (SDA); also elsewhere on the board
/Power/PACK_NEG: CELL3.2 (-), R20.1, R21.1, R26.1
/Power/PCHG: Q31.1 (G), R32.1, U10.40 (PCHG)
/Power/PDSG: Q30.1 (G), R33.2, U10.39 (PDSG)
/Power/VCELL1: CELL2.2 (-), CELL3.1 (+), R22.1
/Power/VCELL2: CELL1.2 (-), CELL2.1 (+), R23.1
/Power/VCELL3: CELL1.1 (+), D5.2 (A), FUSE1.3, R24.1
GND: C56.1, C57.1, C60.1, C61.1, C65.1, C66.1, C67.1, C68.1, C69.1, C71.1, C72.1, R20.2, R27.1, R38.1, TH1.2, TH2.2, TH3.2, U10.17 (VSS), U14.3 (GND); also elsewhere on the board
unnamed: D5.1 (K), R25.1
unnamed: C66.2, D6.1 (K), Q28.2 (C)
unnamed: Q27.1 (G), R31.2, U10.43 (DSG)
unnamed: Q28.1 (B), U10.37 (BREG)
unnamed: Q28.3 (E), U10.36 (REGIN)
unnamed: Q29.1 (G), R30.1, U10.45 (CHG)
unnamed: FUSE1.1, Q29.3 (S), R30.2, R35.1
unnamed: Q30.3 (S), R34.1
unnamed: Q31.3 (S), R35.2
unnamed: C60.2, C61.2, C62.1, R25.2, U10.47 (BAT)
unnamed: C62.2, U10.46 (CP1)
unnamed: R28.1, U10.41 (LD)
unnamed: R29.1, U10.42 (PACK)
unnamed: C65.2, U10.24 (REG18)
unnamed: C63.1, C64.1, R27.2, U10.20 (SRN)
unnamed: C63.2, C64.2, R26.2, U10.18 (SRP)
unnamed: TH1.1, U10.21 (TS1)
unnamed: TH2.1, U10.22 (TS2)
unnamed: TH3.1, U10.23 (TS3)
unnamed: C56.2, R21.2, U10.16 (VC0)
unnamed: C57.2, C58.1, R22.2, U10.15 (VC1)
unnamed: C58.2, C59.1, R23.2, U10.14 (VC2)
unnamed: C59.2, R24.2, U10.13 (VC3)
unnamed: R36.2, U14.5 (EN)
unnamed: C70.1, L5.2, U14.2 (SW)
unnamed: C70.2, U14.4 (VBST)
unnamed: R37.1, R38.2, U14.6 (VFB)

Notes on the sheet:
NOTE: Fuse is 1230 Model!! Same symbol
Vout=0.804* *(1+Rb/Rt)
Protection Fuse
Overcurrent SENSE Resistor R = 200mV/Imax I = 200mV/5mOhm = 40 A
3S 11V battery pack Notes: Connect BATT and BATTN

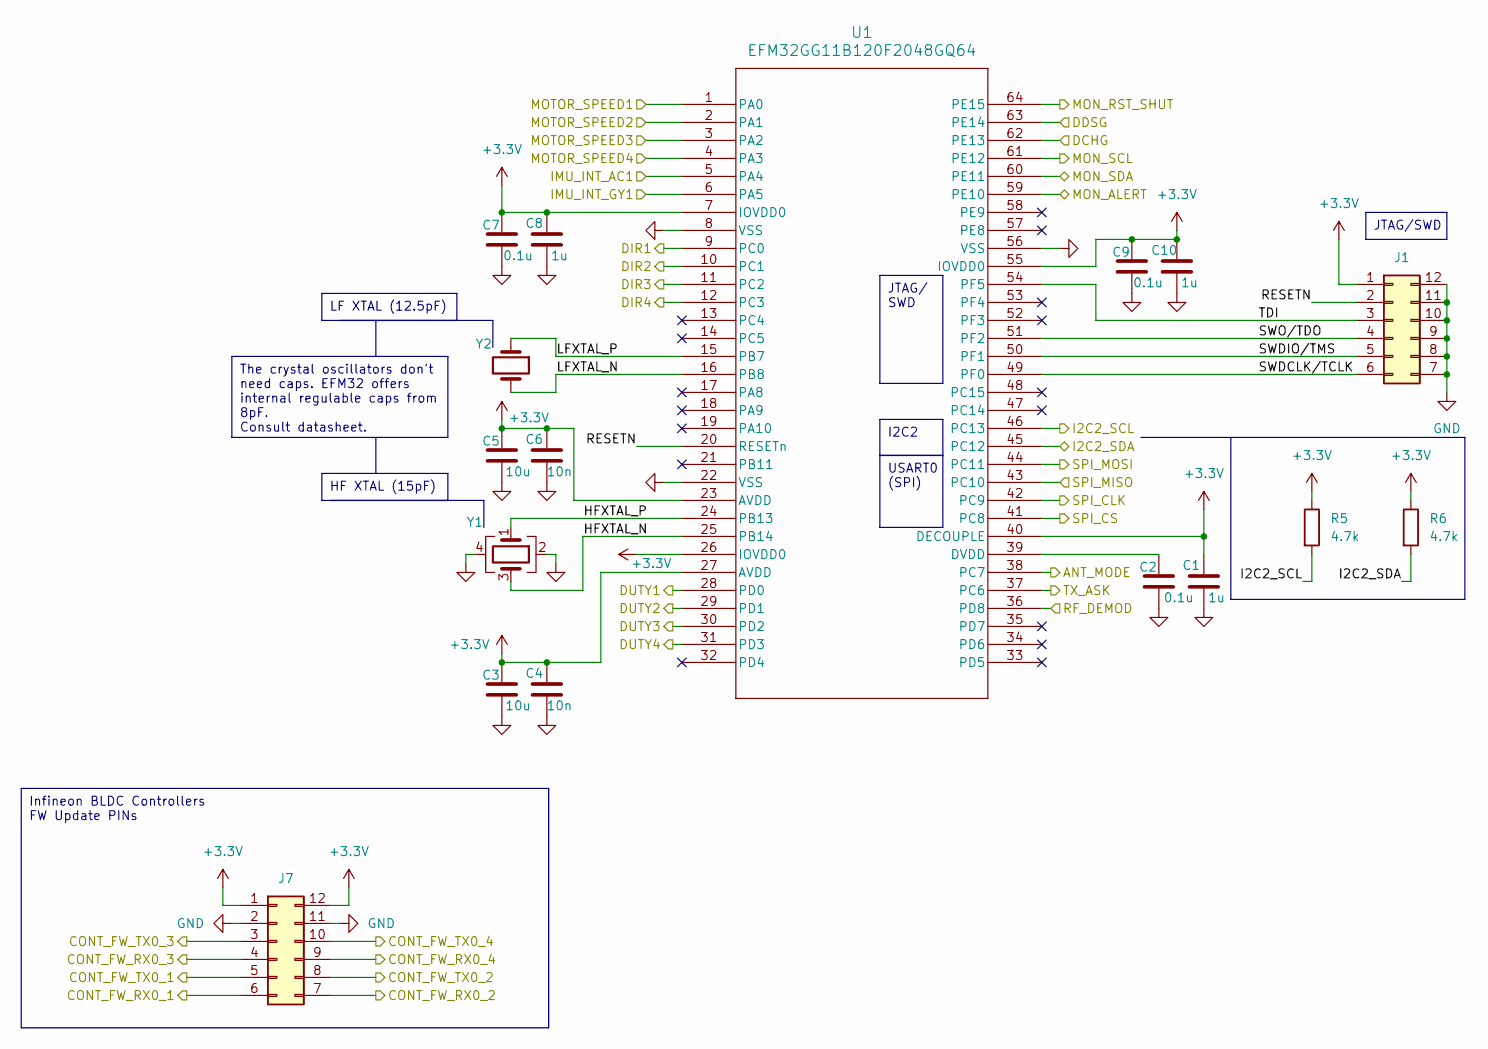
[picture p12: schematic mcu.kicad_sch, Quincy FMU]

Parts:
C1, C8, C10: 1u; C_0805_2012Metric_Pad1.18x1.45mm_HandSolder
C2, C7, C9: 0.1u; C_0805_2012Metric_Pad1.18x1.45mm_HandSolder
C3, C5: 10u; C_0805_2012Metric_Pad1.18x1.45mm_HandSolder
C4, C6: 10n; C_0805_2012Metric_Pad1.18x1.45mm_HandSolder
J1, J7: Conn_02x06_Counter_Clockwise; PinHeader_2x06_P2.54mm_Vertical
R5, R6: 4.7k; R_0805_2012Metric_Pad1.20x1.40mm_HandSolder
U1: EFM32GG11B120F2048GQ64; TQFP64_10X10_SIL
Y1: Crystal_GND24; Crystal_SMD_3225-4Pin_3.2x2.5mm_HandSoldering
Y2: Crystal; Crystal_SMD_EuroQuartz_EQ161-2Pin_3.2x1.5mm_HandSoldering

Connections:
+3.3V: C1.1, C3.1, C4.1, C5.1, C6.1, C7.1, C8.1, C9.1, C10.1, J1.1, J7.1, J7.12, R5.1, R6.1, U1.7 (IOVDD0), U1.23 (AVDD), U1.26 (IOVDD0), U1.27 (AVDD), U1.40 (DECOUPLE), U1.55 (IOVDD0); also elsewhere on the board
/Microcontroller/ANT_MODE: U1.38 (PC7); also elsewhere on the board
/Microcontroller/CONT_FW_RX0_1: J7.6; also elsewhere on the board
/Microcontroller/CONT_FW_RX0_2: J7.7; also elsewhere on the board
/Microcontroller/CONT_FW_RX0_3: J7.4; also elsewhere on the board
/Microcontroller/CONT_FW_RX0_4: J7.9; also elsewhere on the board
/Microcontroller/CONT_FW_TX0_1: J7.5; also elsewhere on the board
/Microcontroller/CONT_FW_TX0_2: J7.8; also elsewhere on the board
/Microcontroller/CONT_FW_TX0_3: J7.3; also elsewhere on the board
/Microcontroller/CONT_FW_TX0_4: J7.10; also elsewhere on the board
/Microcontroller/DCHG: U1.62 (PE13); also elsewhere on the board
/Microcontroller/DDSG: U1.63 (PE14); also elsewhere on the board
/Microcontroller/DIR1: U1.9 (PC0); also elsewhere on the board
/Microcontroller/DIR2: U1.10 (PC1); also elsewhere on the board
/Microcontroller/DIR3: U1.11 (PC2); also elsewhere on the board
/Microcontroller/DIR4: U1.12 (PC3); also elsewhere on the board
/Microcontroller/DUTY1: U1.28 (PD0); also elsewhere on the board
/Microcontroller/DUTY2: U1.29 (PD1); also elsewhere on the board
/Microcontroller/DUTY3: U1.30 (PD2); also elsewhere on the board
/Microcontroller/DUTY4: U1.31 (PD3); also elsewhere on the board
/Microcontroller/HFXTAL_N: U1.25 (PB14), Y1.3
/Microcontroller/HFXTAL_P: U1.24 (PB13), Y1.1
/Microcontroller/I2C2_SCL: R5.2, U1.46 (PC13); also elsewhere on the board
/Microcontroller/I2C2_SDA: R6.2, U1.45 (PC12); also elsewhere on the board
/Microcontroller/IMU_INT_AC1: U1.5 (PA4); also elsewhere on the board
/Microcontroller/IMU_INT_GY1: U1.6 (PA5); also elsewhere on the board
/Microcontroller/LFXTAL_N: U1.16 (PB8), Y2.2
/Microcontroller/LFXTAL_P: U1.15 (PB7), Y2.1
/Microcontroller/MON_ALERT: U1.59 (PE10); also elsewhere on the board
/Microcontroller/MON_RST_SHUT: U1.64 (PE15); also elsewhere on the board
/Microcontroller/MOTOR_SPEED1: U1.1 (PA0); also elsewhere on the board
/Microcontroller/MOTOR_SPEED2: U1.2 (PA1); also elsewhere on the board
/Microcontroller/MOTOR_SPEED3: U1.3 (PA2); also elsewhere on the board
/Microcontroller/MOTOR_SPEED4: U1.4 (PA3); also elsewhere on the board
/Microcontroller/RESETN: J1.2, U1.20 (RESETn)
/Microcontroller/RF_DEMOD: U1.36 (PD8); also elsewhere on the board
/Microcontroller/SPI_CLK: U1.42 (PC9)
/Microcontroller/SPI_CS: U1.41 (PC8)
/Microcontroller/SPI_MISO: U1.43 (PC10)
/Microcontroller/SPI_MOSI: U1.44 (PC11)
/Microcontroller/SWDCLK/TCLK: J1.6, U1.49 (PF0)
/Microcontroller/SWDIO/TMS: J1.5, U1.50 (PF1)
/Microcontroller/SWO/TDO: J1.4, U1.51 (PF2)
/Microcontroller/TDI: J1.3, U1.54 (PF5)
/Microcontroller/TX_ASK: U1.37 (PC6); also elsewhere on the board
/Power/MON_SCL: U1.61 (PE12); also elsewhere on the board
/Power/MON_SDA: U1.60 (PE11); also elsewhere on the board
GND: C1.2, C2.2, C3.2, C4.2, C5.2, C6.2, C7.2, C8.2, C9.2, C10.2, J1.7, J1.8, J1.9, J1.10, J1.11, J1.12, J7.2, J7.11, U1.8 (VSS), U1.22 (VSS), U1.56 (VSS), Y1.2, Y1.4; also elsewhere on the board
unnamed: C2.1, U1.39 (DVDD)

Notes on the sheet:
JTAG/ SWD
JTAG/SWD
The crystal oscillators don't need caps. EFM32 offers internal regulable caps from 8pF. Consult datasheet.
HF XTAL (15pF)
Infineon BLDC Controllers FW Update PINs
I2C2
USART0 (SPI)
LF XTAL (12.5pF)

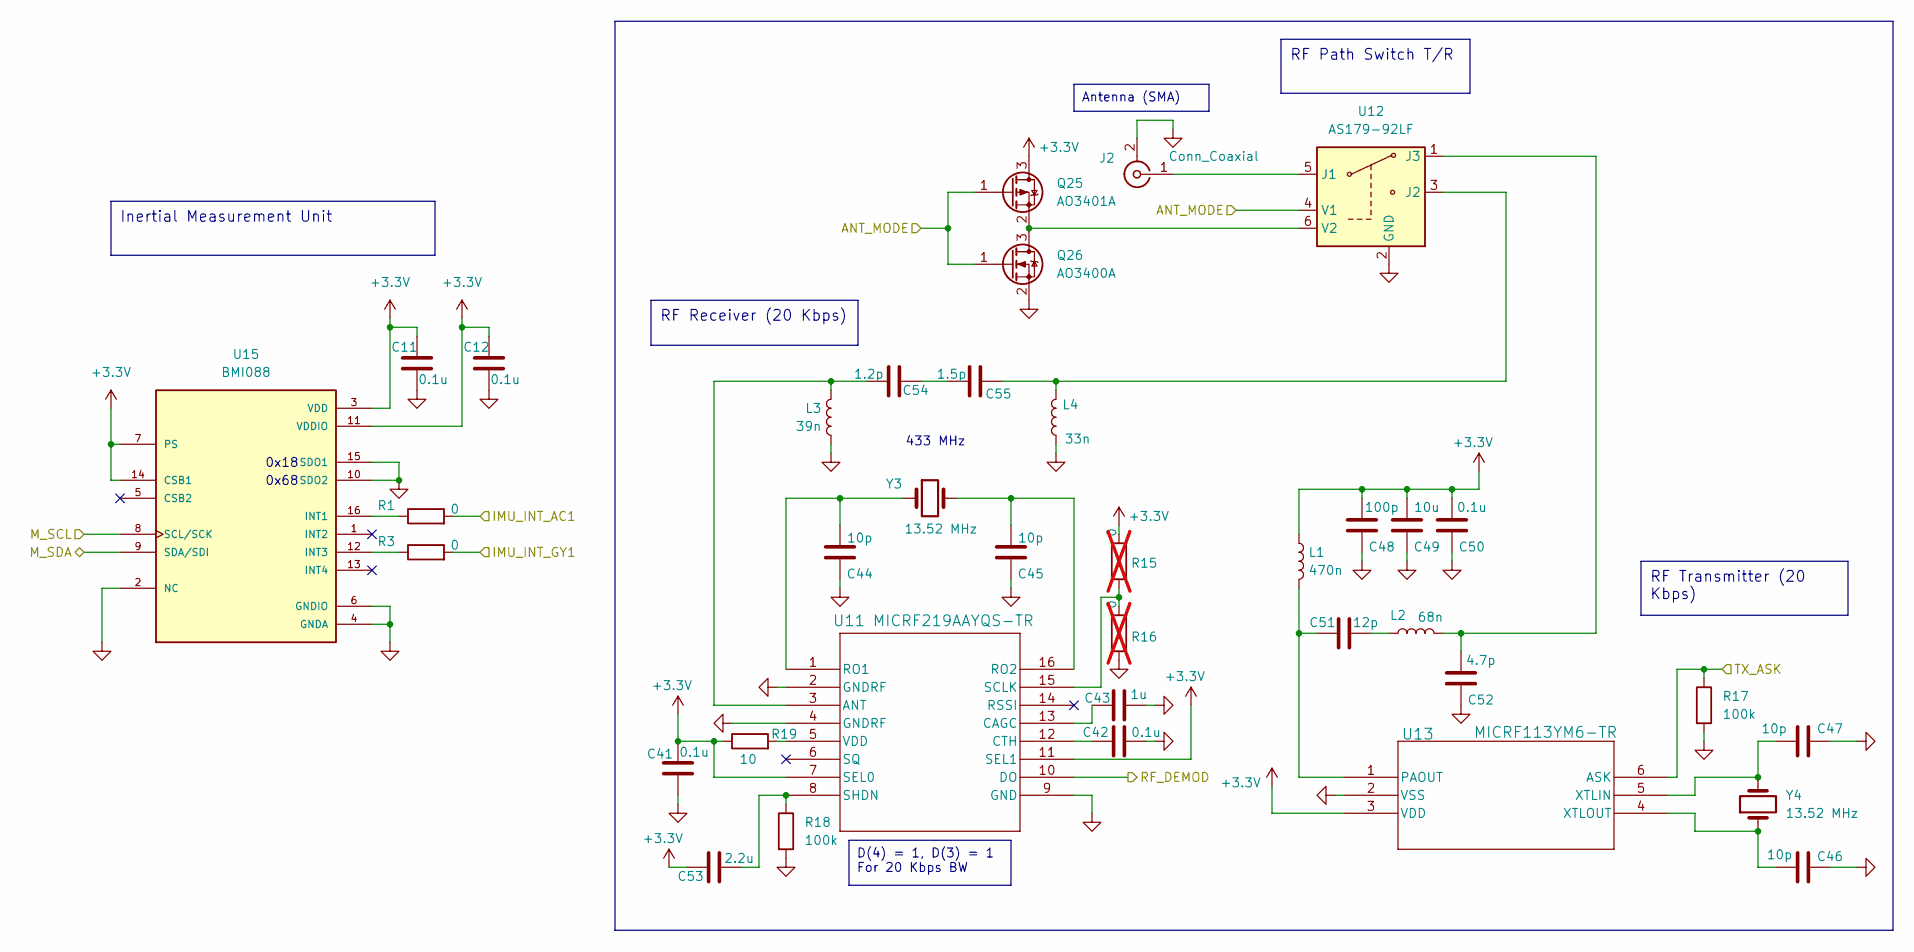
[picture p13: schematic sensors_rf.kicad_sch, Quincy FMU]

Parts:
C11, C12, C41, C42, C50: 0.1u; C_0805_2012Metric_Pad1.18x1.45mm_HandSolder
C43: 1u; C_0805_2012Metric_Pad1.18x1.45mm_HandSolder
C44, C45, C46, C47: 10p; C_0805_2012Metric_Pad1.18x1.45mm_HandSolder
C48: 100p; C_0805_2012Metric_Pad1.18x1.45mm_HandSolder
C49: 10u; C_0805_2012Metric_Pad1.18x1.45mm_HandSolder
C51: 12p; C_0603_1608Metric_Pad1.08x0.95mm_HandSolder
C52: 4.7p; C_0603_1608Metric_Pad1.08x0.95mm_HandSolder
C53: 2.2u; C_0805_2012Metric_Pad1.18x1.45mm_HandSolder
C54: 1.2p; C_0603_1608Metric_Pad1.08x0.95mm_HandSolder
C55: 1.5p; C_0603_1608Metric_Pad1.08x0.95mm_HandSolder
J2: Conn_Coaxial; SMA_Amphenol_901-144_Vertical
L1: 470n; L_0402_1005Metric_Pad0.77x0.64mm_HandSolder
L2: 68n; L_0603_1608Metric_Pad1.05x0.95mm_HandSolder
L3: 39n; L_0402_1005Metric_Pad0.77x0.64mm_HandSolder
L4: 33n; L_0603_1608Metric_Pad1.05x0.95mm_HandSolder
Q25: AO3401A; SOT-23
Q26: AO3400A; SOT-23
R1, R3: 0; R_0805_2012Metric_Pad1.20x1.40mm_HandSolder
R15, R16: 0; R_0805_2012Metric_Pad1.20x1.40mm_HandSolder; not fitted
R17, R18: 100k; R_0805_2012Metric_Pad1.20x1.40mm_HandSolder
R19: 10; R_0805_2012Metric_Pad1.20x1.40mm_HandSolder
U11: MICRF219AAYQS-TR; QSOP16_MC_MCH
U12: AS179-92LF; SOT-363_SC-70-6
U13: MICRF113YM6-TR; SOT-23-6_MC_MCH
U15: BMI088; PQFN50P450X300X100-16N
Y3, Y4: 13.52 MHz; Crystal_HC49-U_Horizontal

Connections:
+3.3V: C11.1, C12.1, C41.1, C48.2, C49.2, C50.2, C53.1, L1.1, Q25.3 (D), R15.2, R19.1, U11.7 (SEL0), U11.11 (SEL1), U13.3 (VDD), U15.3 (VDD), U15.7 (PS), U15.11 (VDDIO), U15.14 (CSB1); also elsewhere on the board
/Microcontroller/ANT_MODE: Q25.1 (G), Q26.1 (G), U12.4 (V1); also elsewhere on the board
/Microcontroller/I2C2_SCL: U15.8 (SCL/SCK); also elsewhere on the board
/Microcontroller/I2C2_SDA: U15.9 (SDA/SDI); also elsewhere on the board
/Microcontroller/IMU_INT_AC1: R1.2; also elsewhere on the board
/Microcontroller/IMU_INT_GY1: R3.2; also elsewhere on the board
/Microcontroller/RF_DEMOD: U11.10 (DO); also elsewhere on the board
/Microcontroller/TX_ASK: R17.1, U13.6 (ASK); also elsewhere on the board
GND: C11.2, C12.2, C41.2, C42.2, C43.2, C44.1, C45.1, C46.1, C47.1, C48.1, C49.1, C50.1, C52.1, J2.2 (Ext), L3.2, L4.2, Q26.2 (S), R16.1, R17.2, R18.2, U11.2 (GNDRF), U11.4 (GNDRF), U11.9 (GND), U12.2 (GND), U13.2 (VSS), U15.2 (NC), U15.4 (GNDA), U15.6 (GNDIO), U15.10 (SDO2), U15.15 (SDO1); also elsewhere on the board
unnamed: C51.2, L2.1
unnamed: C54.1, C55.2
unnamed: J2.1 (In), U12.5 (J1)
unnamed: Q25.2 (S), Q26.3 (D), U12.6 (V2)
unnamed: C54.2, L3.1, U11.3 (ANT)
unnamed: C43.1, U11.13 (CAGC)
unnamed: C42.1, U11.12 (CTH)
unnamed: C44.2, U11.1 (RO1), Y3.1
unnamed: C45.2, U11.16 (RO2), Y3.2
unnamed: R15.1, R16.2, U11.15 (SCLK)
unnamed: C53.2, R18.1, U11.8 (SHDN)
unnamed: R19.2, U11.5 (VDD)
unnamed: C55.1, L4.1, U12.3 (J2)
unnamed: C52.2, L2.2, U12.1 (J3)
unnamed: C51.1, L1.2, U13.1 (PAOUT)
unnamed: C47.2, U13.5 (XTLIN), Y4.2
unnamed: C46.2, U13.4 (XTLOUT), Y4.1
unnamed: R1.1, U15.16 (INT1)
unnamed: R3.1, U15.12 (INT3)

Notes on the sheet:
RF Path Switch T/R
RF Transmitter (20 Kbps)
Antenna (SMA)
D(4) = 1, D(3) = 1 For 20 Kbps BW
RF Receiver (20 Kbps)
Inertial Measurement Unit
0x18
0x68
433 MHz

Board: 4 copper layers, 236 parts (0 on the bottom side), 219 nets, no tracks yet.
