steewbsd/quincy/(commit log)

2024-09-10 feat: basic project structure
    [mcu.kicad_sch, qfmu.kicad_pcb, qfmu.kicad_sch]
2024-09-14 feat: add material list and create library dir
    Create a spreadsheet to annotate BOM and include symbols in lib/
    [mats.ods, mcu.kicad_sch, qfmu.kicad_pcb, qfmu.kicad_sch]
2024-09-28 feat: add MCU, basic motor structure, sensors and power
    Initialize basic structure for the motor, sensor and power sheets.
    Update material list (mats.ods) with more components to be used.
    [mats.ods, mcu.kicad_sch, motor1.kicad_sch, power.kicad_sch, qfmu.kicad_sch, sensors.kicad_sch]
2024-10-13 feat: add new BLDC controler and RF section
    [MaterialList.ods, mats.ods, mcu.kicad_sch, motor1.kicad_sch, power.kicad_sch, qfmu.kicad_pcb, qfmu.kicad_sch, sensors.kicad_sch]
2024-11-10 feat: finish motors, RF and power monitor
    [MaterialList.ods, mcu.kicad_sch, motor1.kicad_sch, power.kicad_sch, qfmu.kicad_pcb, qfmu.kicad_sch, sensors_rf.kicad_sch]
2024-11-12 feat: start PCB design, define board outline and basic placement
    [EdgeCuts.FCStd, MaterialList.ods, edgecuts.dxf, mcu.kicad_sch, motor1.kicad_sch, power.kicad_sch, qfmu.kicad_pcb, qfmu.kicad_sch]
2024-11-15 feat: complete preliminar placement of PCB components
    Organize and place components for routing and export a preliminary BOM
    [EdgeCuts.FCStd, motor1.kicad_sch, qfmu.csv, qfmu.kicad_pcb]
2024-11-16 feat: add basic split power planes and redo edgecuts
    Add power plane zones and fix edgecuts constraints, also reducing the size.
    [EdgeCuts.FCStd, edgecuts.dxf, qfmu.kicad_pcb]
2024-11-16 feat: further routing
    [qfmu.kicad_pcb]
2024-11-16 feat: reposition elements and go back to original edgecuts
    Position elements for easier routing and start from scratch.
    Revert shape design to be fully symmetrical.
    [EdgeCuts.FCStd, edgecuts.dxf, power.kicad_sch, qfmu.kicad_pcb]
2024-11-16 fix: reshape 3V3 power plane
    [EdgeCuts.FCStd, qfmu.kicad_pcb]
2024-11-17 temp: commit previous to routing
    [qfmu.kicad_pcb]
